furbrain/Cyclops/raspbian/diffraction.png

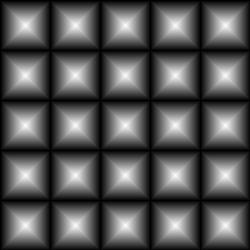
raspbian/diffraction.png
