furbrain/Cyclops/README.md

# Cyclops

Cave surveying with a camera and IMU. Under development
