furbrain/Cyclops/pcb/main/README.TXT

These files have been created in version 8 of KiCAD.

Some of the 3d models need to be downloaded form the following places and put into the CM5IO.3shapes directory some models are approximations.

https://datasheets.raspberrypi.org/cm5/CM5-step.zip
https://www.molex.com/molex/products/part-detail/memory_card_socket/5033981892

The models provided in the 3dmodels directory are from various manufacturers including Diodes, Hirose, MTCONN, Toby, TRXCOM. Terms and conditions for the use of the models remain with the original manufacture.
