furbrain/Cyclops/enclosures/main.FCStd

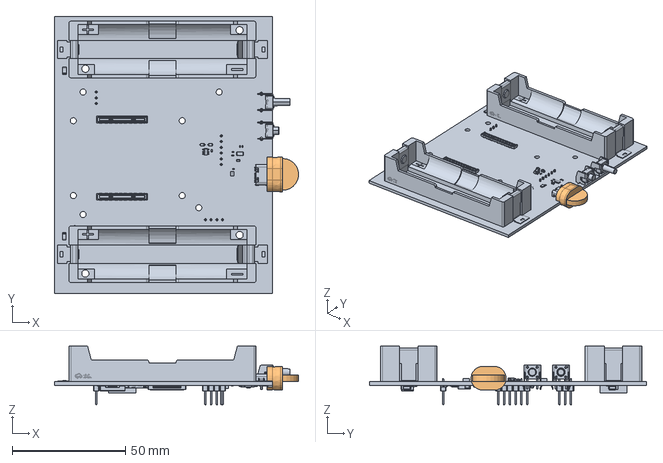
[picture p2: CAD file, 2026-10-15]
enclosures/main.FCStd
107.5 x 122.3 x 25.8 mm
CM5IO
Plug
