furbrain/Cyclops/enclosures/indicator.FCStd

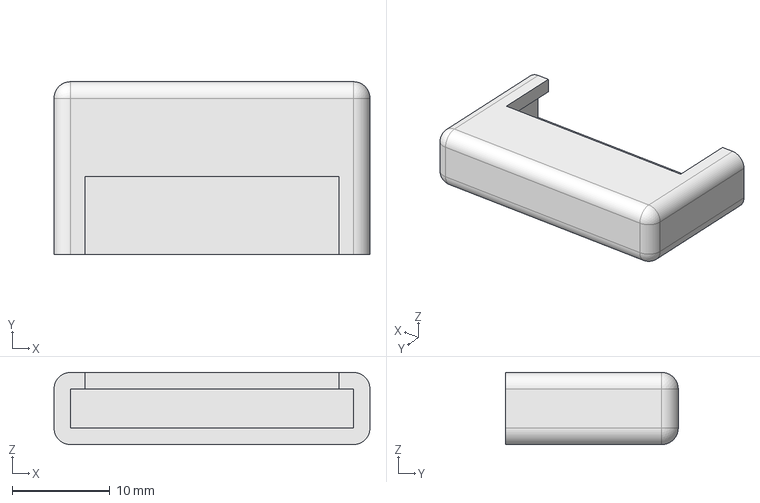
[picture p3: CAD file, 2026-09-15]
enclosures/indicator.FCStd
32.4 x 17.7 x 7.40 mm
