furbrain/Cyclops/enclosures/light_clip.FCStd

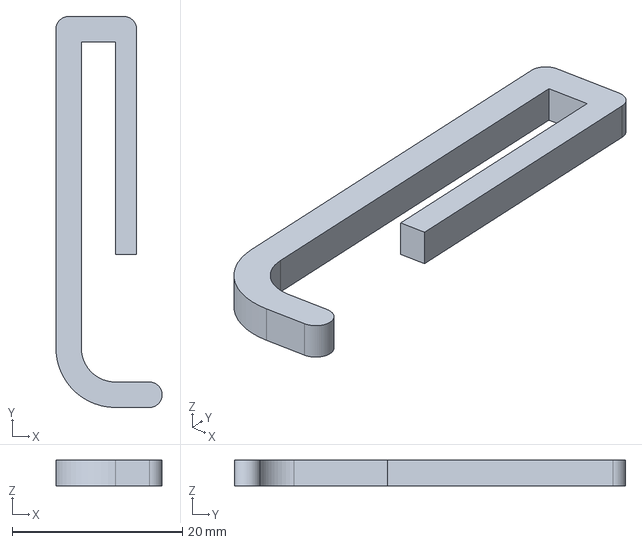
[picture p4: CAD file, 2026-09-15]
enclosures/light_clip.FCStd
12.5 x 46.0 x 3.00 mm
