furbrain/Cyclops/enclosures/vent.FCStd

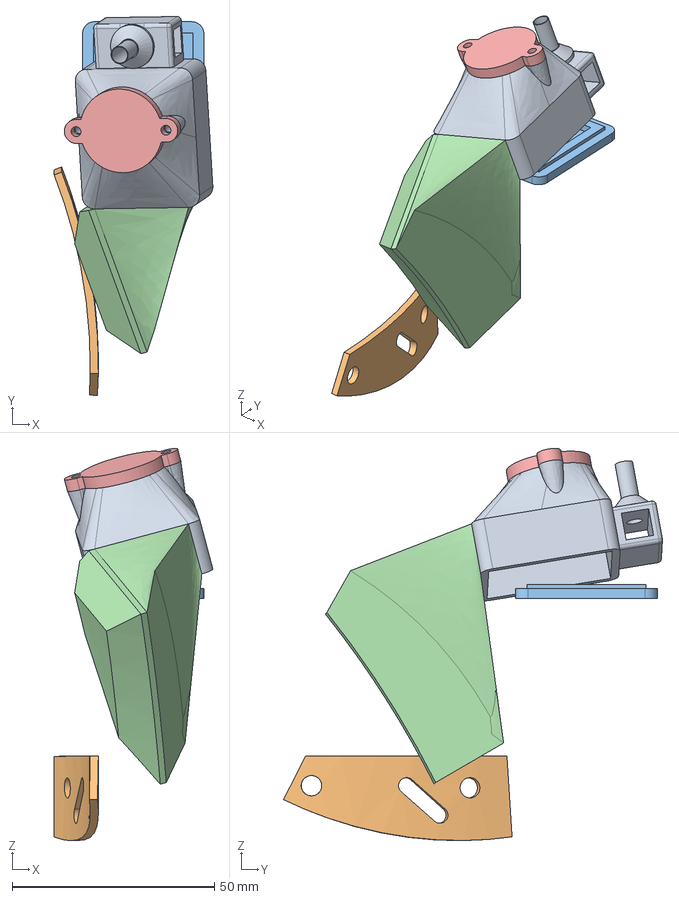
[picture p5: CAD file, 2026-06-04]
enclosures/vent.FCStd
39.2 x 93.6 x 96.9 mm
eye
Plate
backplate
neck
lens
