furbrain/Cyclops/enclosures/froggie_old.FCStd

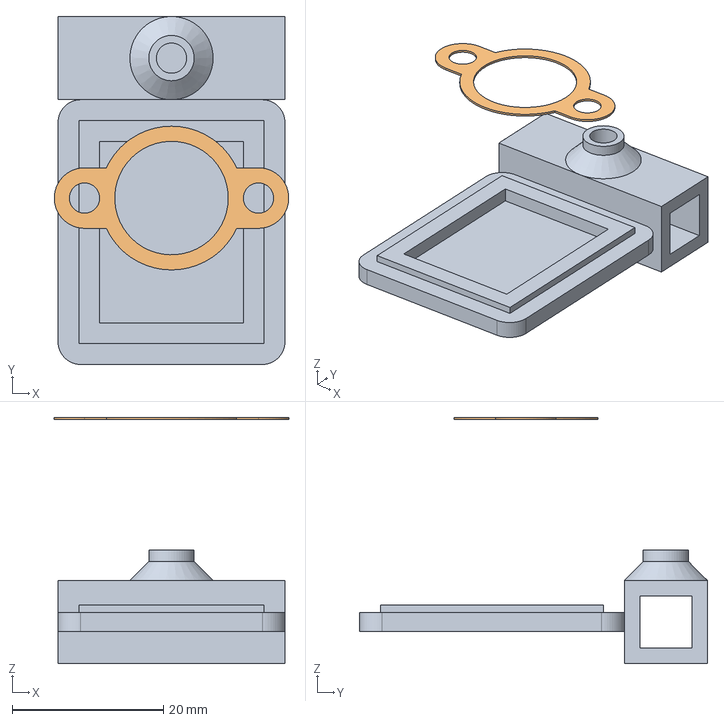
[picture p6: CAD file, 2026-06-04, an earlier design]
enclosures/froggie_old.FCStd
31.0 x 46.0 x 32.5 mm
backplate
Gasket
