furbrain/Cyclops/kalibr/calibration_pattern.pdf

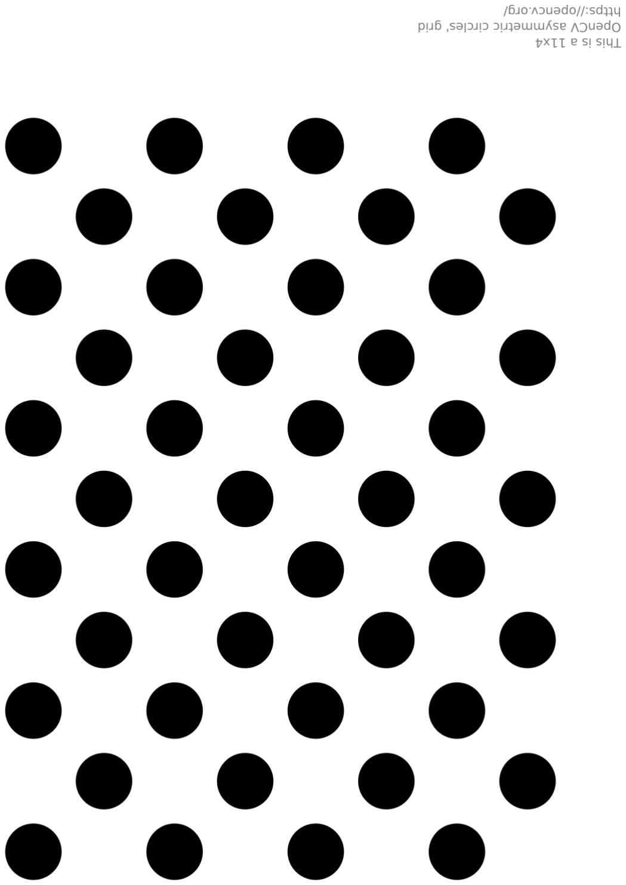
[picture p7: page 1]
