furbrain/Cyclops/pcb/indicator/indicator.kicad_pcb

## KiCad design pcb/indicator/indicator.kicad_pcb (2026-06-24)

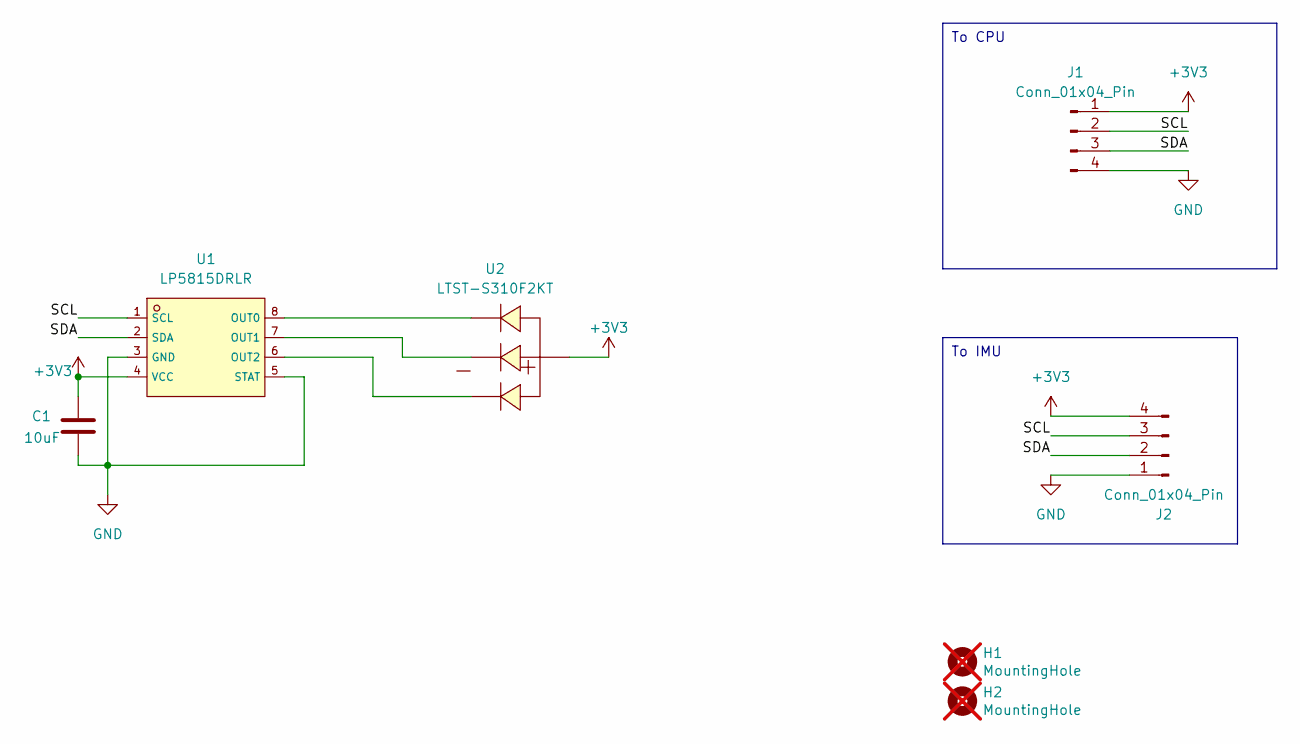
[picture p8: schematic indicator.kicad_sch]

Parts:
C1: 10uF; C_0805_2012Metric; JLCPCB C117956
H1, H2: MountingHole; MountingHole_3.2mm_M3; Part Description M2.5 mounting hole; not fitted
J1, J2: Conn_01x04_Pin; JUSHUO_AFA07-S04FCA-00_1x4-1MP_P1.0mm_Horizontal; JLCPCB C262710
U1: LP5815DRLR; SOT-583-8_L2.1-W1.2-P0.50-LS1.6-BL; JLCPCB C47262831
U2: LTST-S310F2KT; LED-SMD_4P-L3.2-W1.5_LTST-S310F2KT; JLCPCB C284950

Connections:
+3V3: C1.1, J1.1, J2.4, U1.4 (VCC), U2.4 (A)
/SCL: J1.2, J2.3, U1.1 (SCL)
/SDA: J1.3, J2.2, U1.2 (SDA)
GND: C1.2, J1.4, J2.1, U1.3 (GND), U1.5 (STAT)
unnamed: U1.8 (OUT0), U2.1 (C1)
unnamed: U1.7 (OUT1), U2.2 (C2)
unnamed: U1.6 (OUT2), U2.3 (C3)

Notes on the sheet:
To CPU
To IMU

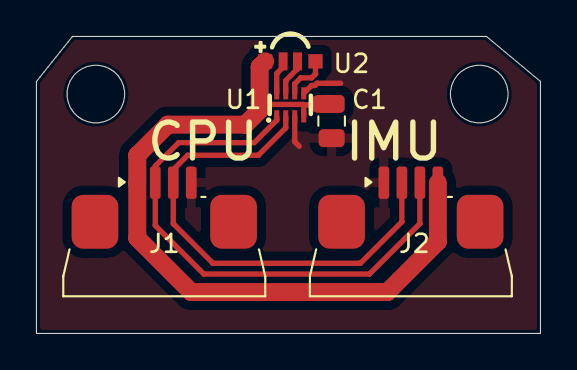
[picture p9: board indicator.kicad_pcb from above]

Board: 2 copper layers, 28.0 x 16.5 mm, 7 parts (0 on the bottom side), 7 nets.
