furbrain/Cyclops/pcb/charger_mod/charger_mod.kicad_pcb

## KiCad design pcb/charger_mod/charger_mod.kicad_pcb (2026-06-04)

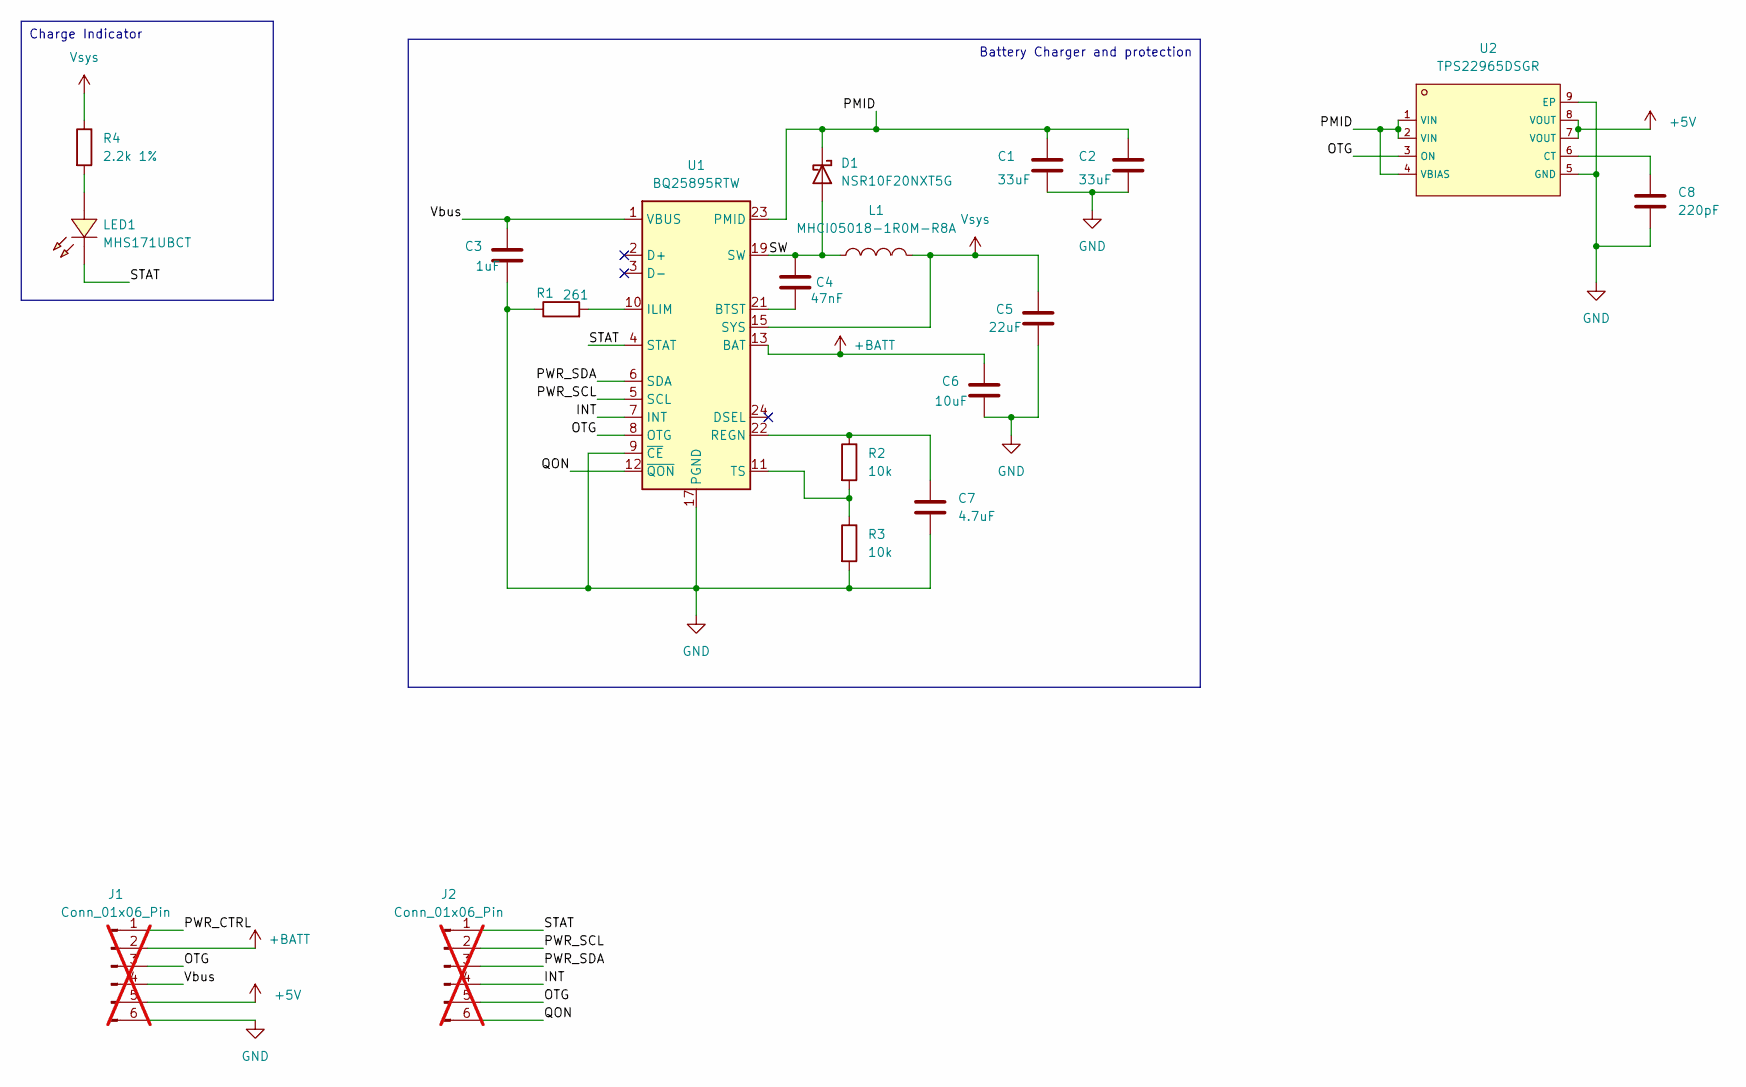
[picture p10: schematic charger_mod.kicad_sch]

Parts:
C1, C2: 33uF; C_1206_3216Metric; LCSC PN C76658
C3: 1uF; C_0603_1608Metric; LCSC PN C1592
C4: 47nF; C_0402_1005Metric; LCSC PN C106260
C5: 22uF; C_0805_2012Metric; LCSC PN C45783
C6: 10uF; C_0805_2012Metric; LCSC PN C117956
C7: 4.7uF; C_0603_1608Metric; LCSC PN C19666
C8: 220pF; C_0402_1005Metric; JLCPCB C1530
D1: NSR10F20NXT5G; Nexperia_DSN1608-2_1.6x0.8mm; LCSC PN C893809
J1, J2: Conn_01x06_Pin; PinHeader_1x06_P2.54mm_Vertical; not fitted
L1: MHCI05018-1R0M-R8A; IND-SMD_L5.7-W5.4; LCSC PN C329539
LED1: MHS171UBCT; LED-SMD_L2.1-W1.0-R-RD; LCSC PN C693906
R1: 261; R_0402_1005Metric; LCSC PN C25097
R2, R3: 10k; R_0402_1005Metric; LCSC PN C25744
R4: 2.2k 1%; R_0402_1005Metric; LCSC PN C25879
U1: BQ25895RTW; Texas_RTW_WQFN-24-1EP_4x4mm_P0.5mm_EP2.7x2.7mm_ThermalVias; LCSC PN C80200
U2: TPS22965DSGR; UDFN-8_L2.0-W2.0-P0.50-TL-EP; LCSC C122837

Connections:
+5V: J1.5, U2.7 (VOUT), U2.8 (VOUT)
+BATT: C6.1, J1.2, U1.13 (BAT), U1.14 (BAT)
/INT: J2.4, U1.7 (INT)
/OTG: J1.3, J2.5, U1.8 (OTG), U2.3 (ON)
/PMID: C1.1, C2.1, D1.1 (K), U1.23 (PMID), U2.1 (VIN), U2.2 (VIN), U2.4 (VBIAS)
/PWR_CTRL: J1.1
/PWR_SCL: J2.2, U1.5 (SCL)
/PWR_SDA: J2.3, U1.6 (SDA)
/QON: J2.6, U1.12 (~QON)
/STAT: J2.1, LED1.2 (K), U1.4 (STAT)
/SW: C4.1, D1.2 (A), L1.1, U1.19 (SW), U1.20 (SW)
/Vbus: C3.1, J1.4, U1.1 (VBUS)
GND: C1.2, C2.2, C3.2, C5.2, C6.2, C7.2, C8.2, J1.6, R1.1, R3.2, U1.9 (~CE), U1.17 (PGND), U1.18 (PGND), U1.25 (PGND), U2.5 (GND), U2.9 (EP)
unnamed: LED1.1 (A), R4.2
unnamed: C4.2, U1.21 (BTST)
unnamed: R1.2, U1.10 (ILIM)
unnamed: C7.1, R2.1, U1.22 (REGN)
unnamed: R2.2, R3.1, U1.11 (TS)
unnamed: C8.1, U2.6 (CT)
Vsys: C5.1, L1.2, R4.1, U1.15 (SYS), U1.16 (SYS)

Notes on the sheet:
Battery Charger and protection
Charge Indicator

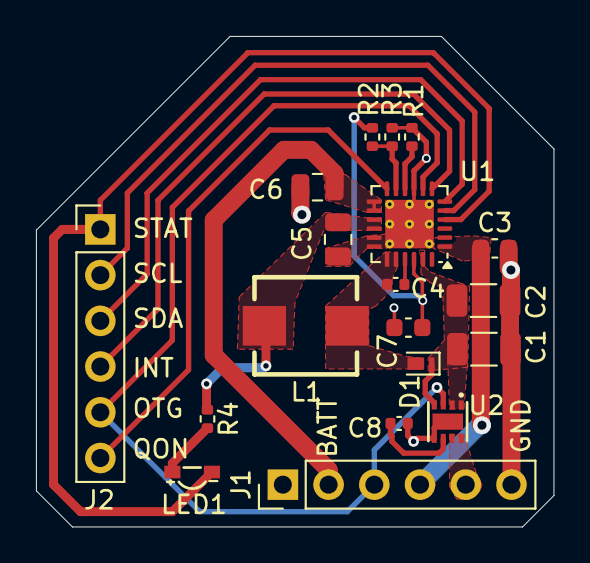
[picture p11: board charger_mod.kicad_pcb from above]

Board: 2 copper layers, 28.8 x 27.2 mm, 19 parts (0 on the bottom side), 19 nets.
