furbrain/Cyclops/pcb/imu/imu.kicad_pcb

## KiCad design pcb/imu/imu.kicad_pcb (2026-06-04)

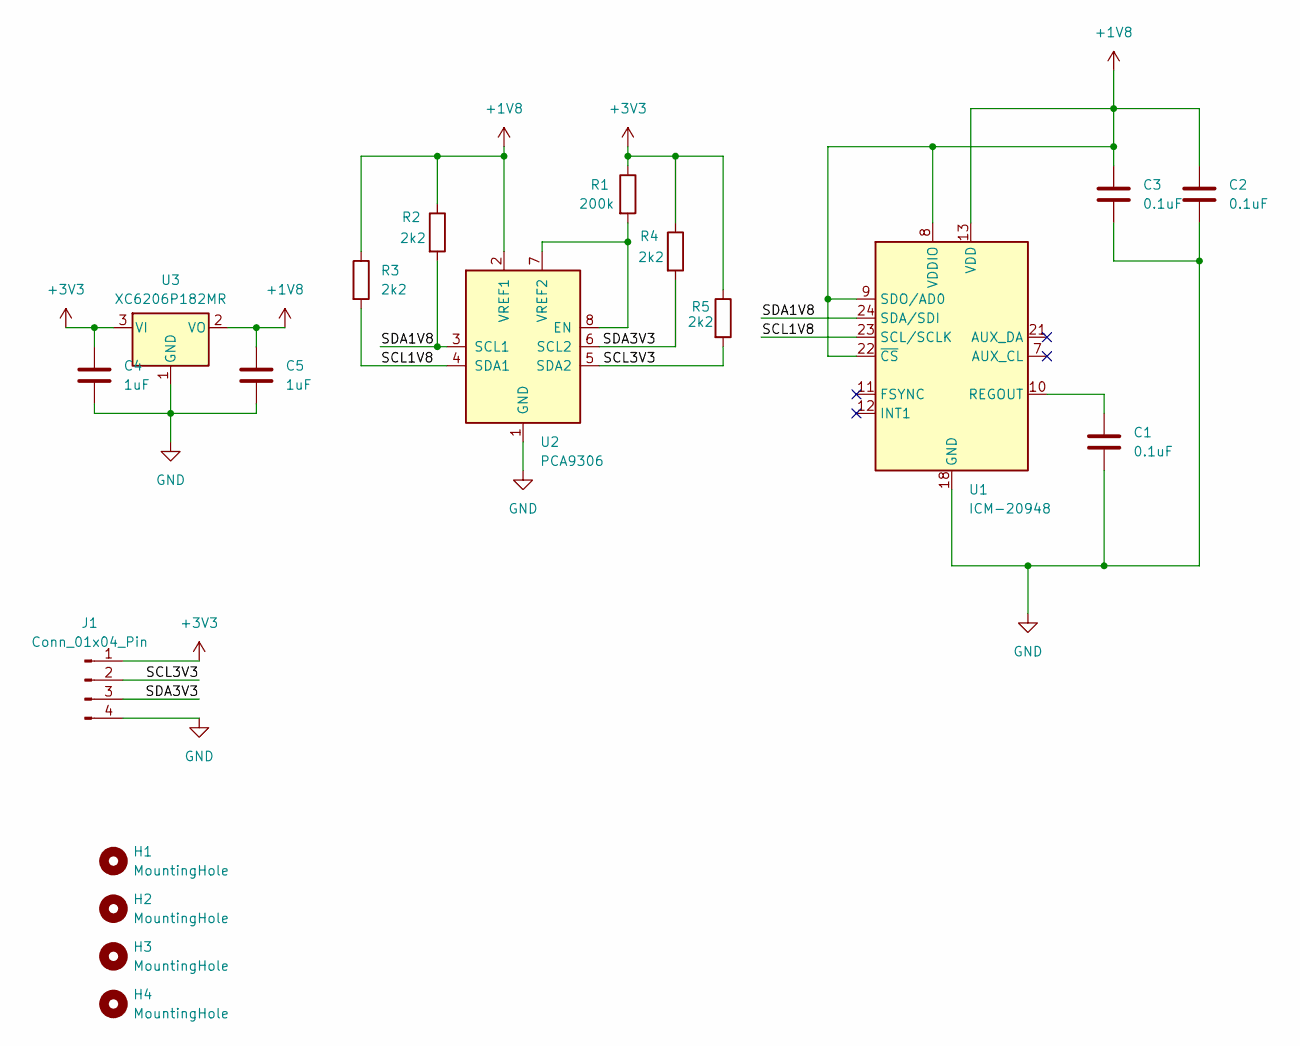
[picture p12: schematic imu.kicad_sch]

Parts:
C1, C2, C3: 0.1uF; C_0402_1005Metric
C4, C5: 1uF; C_0402_1005Metric
H1, H2, H3, H4: MountingHole; MountingHole_2.2mm_M2
J1: Conn_01x04_Pin; JUSHUO_AFA07-S04FCA-00_1x4-1MP_P1.0mm_Horizontal; JLCPCB C262710
R1: 200k; R_0402_1005Metric
R2, R3, R4, R5: 2k2; R_0402_1005Metric
U1: ICM-20948; InvenSense_QFN-24_3x3mm_P0.4mm
U2: PCA9306; VSSOP-8_2.3x2mm_P0.5mm
U3: XC6206P182MR; SOT-23-3; JLCPCB No C21659

Connections:
+1V8: C2.1, C3.1, C5.1, R2.1, R3.1, U1.8 (VDDIO), U1.9 (SDO/AD0), U1.13 (VDD), U1.22 (~CS), U2.2 (VREF1), U3.2 (VO)
+3V3: C4.1, J1.1, R1.1, R4.1, R5.1, U3.3 (VI)
/SCL1V8: R3.2, U1.23 (SCL/SCLK), U2.4 (SDA1)
/SCL3V3: J1.2, R5.2, U2.5 (SDA2)
/SDA1V8: R2.2, U1.24 (SDA/SDI), U2.3 (SCL1)
/SDA3V3: J1.3, R4.2, U2.6 (SCL2)
GND: C1.2, C2.2, C3.2, C4.2, C5.2, J1.4, U1.18 (GND), U1.20 (GND), U2.1 (GND), U3.1 (GND)
unnamed: C1.1, U1.10 (REGOUT)
unnamed: R1.2, U2.7 (VREF2), U2.8 (EN)

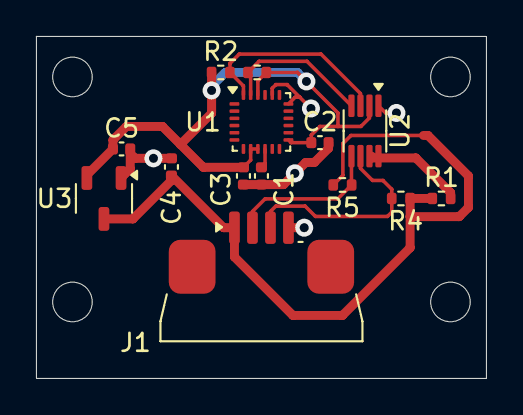
[picture p13: board imu.kicad_pcb from above]

Board: 2 copper layers, 25.0 x 19.0 mm, 18 parts (0 on the bottom side), 9 nets.
