furbrain/Cyclops/pcb/main/main.kicad_pcb

## KiCad design pcb/main/main.kicad_pcb (2026-06-04)

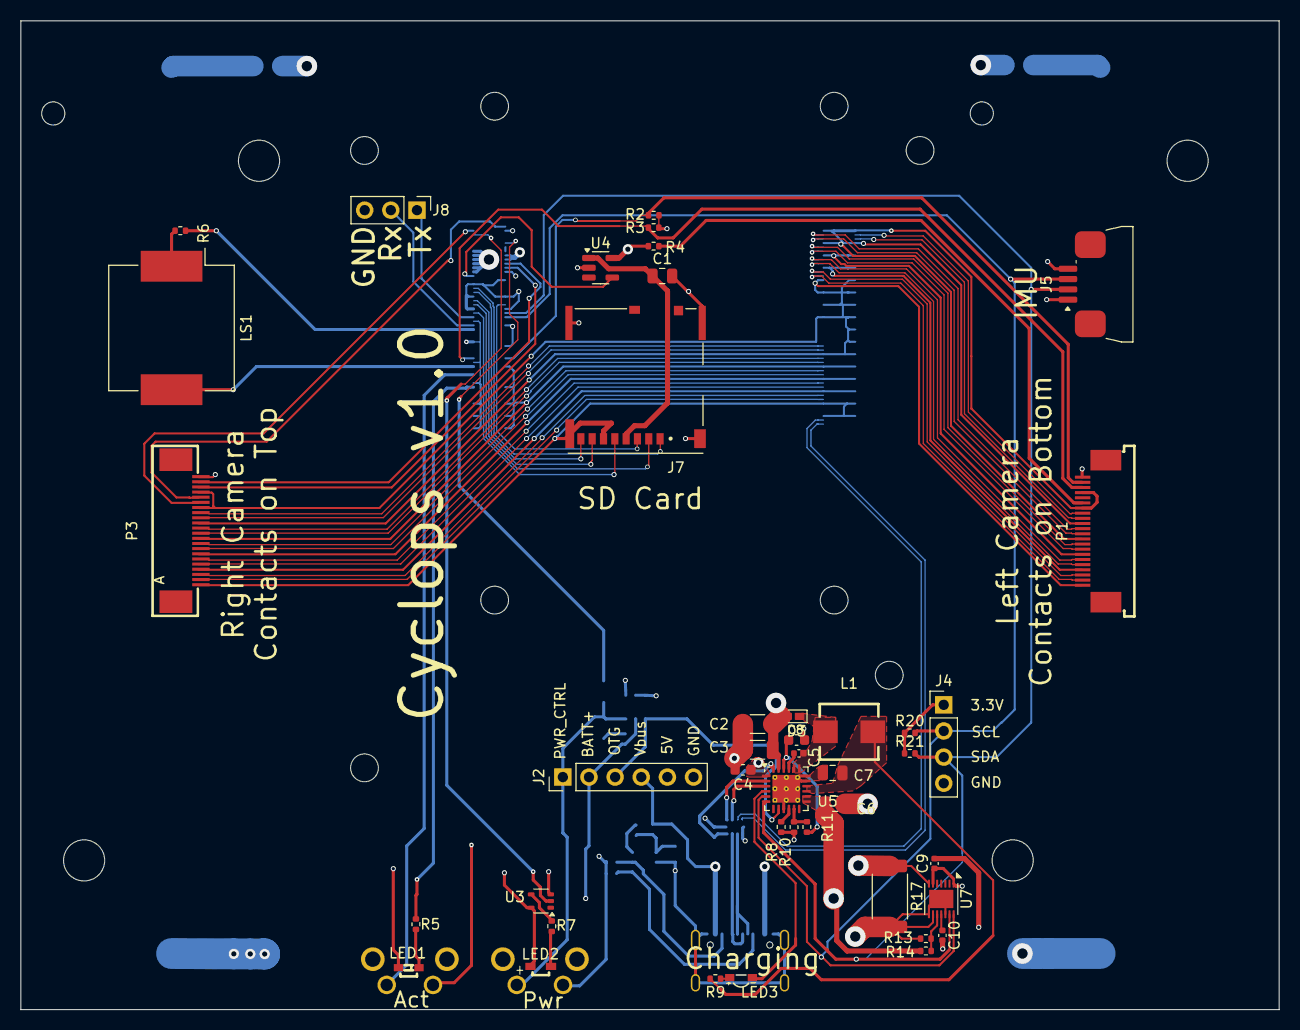
[picture p14: board main.kicad_pcb from above]

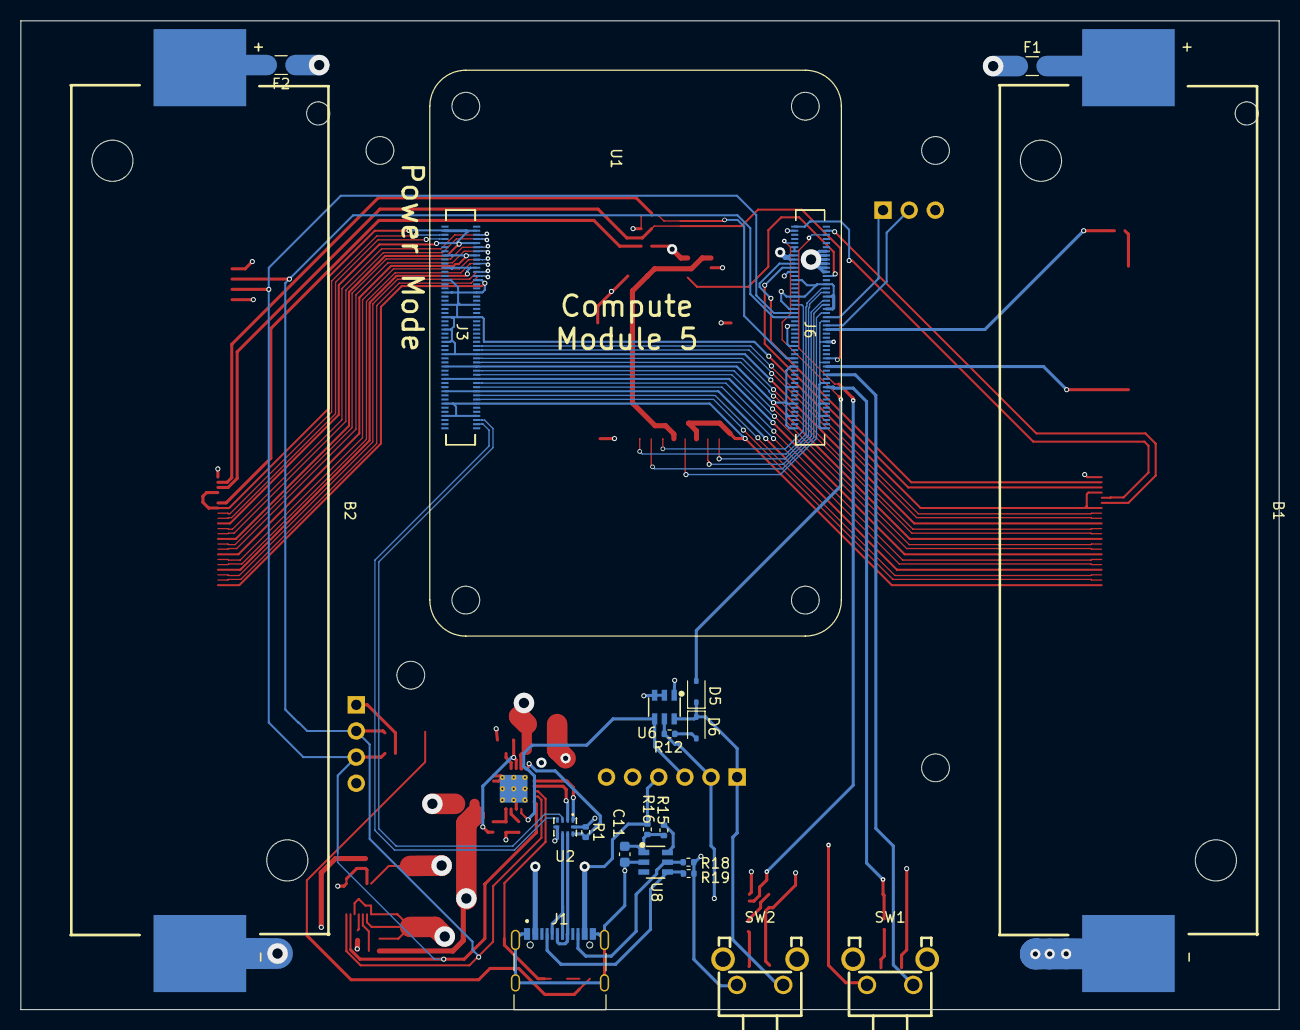
[picture p15: board main.kicad_pcb from below]

Board: 4 copper layers, 122.3 x 96.1 mm, 68 parts (22 on the bottom side), 82 nets.

Parts:
B1, B2: BH-21700-B1BJ001; BAT-SMD_L82.5.5-W25-BH-21700-B1BJ001
C1, C7: 10uF; C_0805_2012Metric
C2, C3: 33uF; C_1206_3216Metric
C4, C11: 1uF; C_0603_1608Metric
C5: 47nF; C_0402_1005Metric
C6: 22uF; C_0805_2012Metric
C8: 4.7uF; C_0603_1608Metric
C9: 100nF; C_0402_1005Metric
C10: 470nF; C_0402_1005Metric
D3: NSR10F20NXT5G; Nexperia_DSN1608-2_1.6x0.8mm
D5, D6: D_Schottky; D_SOD-323
F1, F2: Fuse; Fuse_1206_3216Metric
H1, H2, H3, H4: MountingHole; MountingHole_2.7mm_M2.5_DIN965
J1: TYPE-C-31-M-12; HRO_TYPE-C-31-M-12
J2: Conn_01x06_Pin; PinHeader_1x06_P2.54mm_Vertical
J3, J6: 10164227-1001A1RLF; CM5_connector
J4: Conn_01x04_Pin; PinHeader_1x04_P2.54mm_Vertical
J5: Conn_01x04_Pin; JUSHUO_AFA07-S04FCA-00_1x4-1MP_P1.0mm_Horizontal
J7: Micro_SD_Card_Det; SDCARD_MOLEX_503398-1892
J8: UART Connection; PinHeader_1x03_P2.54mm_Vertical
L1: MHCI05018-1R0M-R8A; IND-SMD_L5.7-W5.4
LED1: MHS171CYCT; LED-SMD_L2.0-W1.1-R-RD-SIDE_YELLOW
LED2: MHS171UGCT; LED-SMD_L2.0-W1.1_RD_GREEN_SIDE
LED3: MHS171UBCT; LED-SMD_L2.1-W1.0-R-RD
LS1: KMTG1203; Buzzer_Mallory_AST1240MLQ
P1: AFC07-S22FCC-00 (Bottom contact); FPC-SMD_AFC07-S22FCC-00
P3: FPC_0_5MM_22P_Pull_type_H2_0mm_Pick_up; FPC-SMD_P0.50-22P_LSSJ-H2.0-22P
R1, R10, R11, R12, R15: 10k; R_0402_1005Metric
R2, R3, R4, R20, R21: 2.2K 1%; R_0402_1005Metric
R5, R7, R16: 1k; R_0402_1005Metric
R6: 180; R_0402_1005Metric
R8: 261; R_0402_1005Metric
R9: 2.2k 1%; R_0402_1005Metric
R13: 300k; R_0402_1005Metric
R14: 200k; R_0402_1005Metric
R17: 10mOhm; R_2512_6332Metric
R18, R19: 5.1k; R_0402_1005Metric
SW1: TS-1093C-A14B3-D1; SW-TH_TS-1093C-A14B3-D1
SW2: TS-1093C-A5B3-D1; SW-TH_TS-1093C-A5B3-D1
U1: Raspberry-Pi-5-Compute-Module
U2: TS3USB221ARSER; UQFN-10_L2.0-W1.5-P0.50-BL
U3: 74LVC1G07SE-7; SOT-353_SC-70-5
U4: RT9742GGJ5; SOT-23-5
U5: BQ25895RTW; Texas_RTW_WQFN-24-1EP_4x4mm_P0.5mm_EP2.7x2.7mm_ThermalVias
U6: SN74LVC1G57DBVR; SOT-23-6_L2.9-W1.6-P0.95-LS2.8-BL
U7: MAX17261xxTD; TDFN-14-1EP_3x3mm_P0.4mm_EP1.78x2.35mm
U8: CH221K; SOT-23-6_L2.9-W1.6-P0.95-LS2.8-BL-2

Connections:
+BATT: C7.1, C9.1, F1.1, F2.1, J2.2, R12.1, R13.1, U5.13 (BAT), U5.14 (BAT), U6.5 (VCC), U7.1 (TH), U7.6 (BATT)
-BATT: B1.2, B2.2, C9.2, C10.2, R14.2, R17.2, U7.8 (GND), U7.9 (CSPL), U7.12 (ALRT), U7.15 (GND)
/+3.3v: J4.1, J5.4, J6.78 (GPIO_VREF(1.8v/3.3v_Input)), J6.84 (+3.3v_(Output)), J6.86 (+3.3v_(Output)), LED1.1 (K), LED2.1 (+), P1.1, P3.1, R1.1, R2.1, R3.1, R4.1, R20.1, R21.1, U2.10 (VCC), U3.5 (VCC), U4.5 (IN), U6.1 (IN1)
/CC1: J1.A5 (CC1), R19.1, U8.4 (CC1)
/CC2: J1.B5 (CC2), R18.2, U8.5 (CC2)
/CM5_5V: C2.1, C3.1, D3.1 (K), J2.5, J6.77 (+5v_(Input)), J6.79 (+5v_(Input)), J6.81 (+5v_(Input)), J6.83 (+5v_(Input)), J6.85 (+5v_(Input)), J6.87 (+5v_(Input)), U5.23 (PMID)
/CM5_GPIO ( Ethernet, GPIO, SDCARD)/+1.8v: J6.88 (+1.8v_(Output)), J6.90 (+1.8v_(Output))
/CM5_GPIO ( Ethernet, GPIO, SDCARD)/BUTTON: J6.27 (GPIO20), SW1.2
/CM5_GPIO ( Ethernet, GPIO, SDCARD)/BUZZ_A: J6.49 (GPIO18), R6.1
/CM5_GPIO ( Ethernet, GPIO, SDCARD)/BUZZ_B: J6.31 (GPIO12), LS1.2
/CM5_GPIO ( Ethernet, GPIO, SDCARD)/CAM_GPIO0: J6.97 (CAM_GPIO0), P3.6
/CM5_GPIO ( Ethernet, GPIO, SDCARD)/CAM_GPIO1: J6.100 (CAM_GPIO1), P3.5
/CM5_GPIO ( Ethernet, GPIO, SDCARD)/GPIO14: J6.55 (GPIO14), J8.1
/CM5_GPIO ( Ethernet, GPIO, SDCARD)/GPIO15: J6.51 (GPIO15), J8.2
/CM5_GPIO ( Ethernet, GPIO, SDCARD)/ID_SC: J6.35 (ID_SC), P1.3, R3.2
/CM5_GPIO ( Ethernet, GPIO, SDCARD)/ID_SD: J6.36 (ID_SD), P1.2, R2.2
/CM5_GPIO ( Ethernet, GPIO, SDCARD)/SD_CLK: J6.57 (SD_CLK), J7.5 (CLK)
/CM5_GPIO ( Ethernet, GPIO, SDCARD)/SD_CMD: J6.62 (SD_CMD), J7.3 (CMD)
/CM5_GPIO ( Ethernet, GPIO, SDCARD)/SD_DAT0: J6.63 (SD_DAT0), J7.7 (DAT0)
/CM5_GPIO ( Ethernet, GPIO, SDCARD)/SD_DAT1: J6.67 (SD_DAT1), J7.8 (DAT1)
/CM5_GPIO ( Ethernet, GPIO, SDCARD)/SD_DAT2: J6.69 (SD_DAT2), J7.1 (DAT2)
/CM5_GPIO ( Ethernet, GPIO, SDCARD)/SD_DAT3: J6.61 (SD_DAT3), J7.2 (DAT3/CD)
/CM5_GPIO ( Ethernet, GPIO, SDCARD)/SD_PWR: C1.1, J7.4 (VDD), U4.1 (OUT)
/CM5_GPIO ( Ethernet, GPIO, SDCARD)/SD_PWR_ON: J6.75 (SD_PWR_ON), U4.4 (EN)
/CM5_GPIO ( Ethernet, GPIO, SDCARD)/nPWR_LED: J6.95 (LED_nPWR), U3.2
/CM5_HighSpeed/DPHY0_C_N: J3.27 (MIPI0_C_N), P3.15
/CM5_HighSpeed/DPHY0_C_P: J3.29 (MIPI0_C_P), P3.14
/CM5_HighSpeed/DPHY0_D0_N: J3.15 (MIPI0_D0_N), P3.21
/CM5_HighSpeed/DPHY0_D0_P: J3.17 (MIPI0_D0_P), P3.20
/CM5_HighSpeed/DPHY0_D1_N: J3.21 (MIPI0_D1_N), P3.18
/CM5_HighSpeed/DPHY0_D1_P: J3.23 (MIPI0_D1_P), P3.17
/CM5_HighSpeed/DPHY0_D2_N: J3.33 (MIPI0_D2_N), P3.12
/CM5_HighSpeed/DPHY0_D2_P: J3.35 (MIPI0_D2_P), P3.11
/CM5_HighSpeed/DPHY0_D3_N: J3.39 (MIPI0_D3_N), P3.9
/CM5_HighSpeed/DPHY0_D3_P: J3.41 (MIPI0_D3_P), P3.8
/CM5_HighSpeed/DPHY1_C_N: J3.87 (MIPI1_C_N), P1.15
/CM5_HighSpeed/DPHY1_C_P: J3.89 (MIPI1_C_P), P1.14
/CM5_HighSpeed/DPHY1_D0_N: J3.75 (MIPI1_D0_N), P1.21
/CM5_HighSpeed/DPHY1_D0_P: J3.77 (MIPI1_D0_P), P1.20
/CM5_HighSpeed/DPHY1_D1_N: J3.81 (MIPI1_D1_N), P1.18
/CM5_HighSpeed/DPHY1_D1_P: J3.83 (MIPI1_D1_P), P1.17
/CM5_HighSpeed/DPHY1_D2_N: J3.93 (MIPI1_D2_N), P1.12
/CM5_HighSpeed/DPHY1_D2_P: J3.95 (MIPI1_D2_P), P1.11
/CM5_HighSpeed/DPHY1_D3_N: J3.94 (MIPI1_D3_N), P1.9
/CM5_HighSpeed/DPHY1_D3_P: J3.96 (MIPI1_D3_P), P1.8
/CM5_HighSpeed/SCL0: J6.80 (SCL0), P3.3
/CM5_HighSpeed/SDA0: J6.82 (SDA0), P3.2
/CM5_USB2_N: J3.3 (USB2_N), U2.4 (2D-)
/CM5_USB2_P: J3.5 (USB2_P), U2.3 (2D+)
/DSEL: R1.2, U2.9 (S), U5.24 (DSEL)
/PWR_BUT: D5.2 (A), J6.92 (PWR_BUT)
/PWR_D+: U2.1 (1D+), U5.2 (D+)
/PWR_D-: U2.2 (1D-), U5.3 (D-)
/PWR_SCL: J4.2, J5.3, J6.56 (GPIO3), R20.2, U5.5 (SCL), U7.14 (SCL)
/PWR_SDA: J4.3, J5.2, J6.58 (GPIO2), R21.2, U5.6 (SDA), U7.13 (SDA)
/Power/OTG: J2.3, U5.8 (OTG), U6.4 (Y)
/Power/PWR_CTRL: D5.1 (K), D6.1 (K), J2.1, SW2.2, U6.6 (IN2)
/Power/STAT: LED3.2 (K), U5.4 (STAT)
/Power/SW: C5.1, D3.2 (A), L1.1, U5.19 (SW), U5.20 (SW)
/USB2_N: J1.A7 (DN1), J1.B7 (DN2), U2.7 (D-)
/USB2_P: J1.A6 (DP1), J1.B6 (DP2), U2.8 (D+)
/Vbus: C4.1, J1.A4_B9 (VBUS), J1.B4_A9 (VBUS), J2.4, R16.1, U5.1 (VBUS)
GND: C1.2, C2.2, C3.2, C4.2, C6.2, C7.2, C8.2, C11.2, J1.A1_B12 (GND), J1.B1_A12 (GND), J1.S1 (SHIELD), J1.S2 (SHIELD), J1.S3 (SHIELD), J1.S4 (SHIELD), J2.6, J3.7 (GND), J3.8 (GND), J3.13 (GND), J3.14 (GND), J3.19 (GND), J3.20 (GND), J3.25 (GND), J3.26 (GND), J3.31 (GND), J3.32 (GND), J3.37 (GND), J3.38 (GND), J3.44 (GND), J3.50 (GND), J3.55 (GND), J3.56 (GND), J3.61 (GND), J3.62 (GND), J3.67 (GND), J3.68 (GND), J3.73 (GND), J3.74 (GND), J3.79 (GND), J3.80 (GND), J3.85 (GND), J3.86 (GND), J3.91 (GND), J3.92 (GND), J3.97 (GND), J3.98 (GND), J4.4, J5.1, J6.1 (GND), J6.2 (GND), J6.7 (GND), J6.8 (GND), J6.13 (GND), J6.14 (GND), J6.22 (GND), J6.23 (GND), J6.32 (GND), J6.33 (GND), J6.42 (GND), J6.43 (GND), J6.52 (GND), J6.53 (GND), J6.59 (GND), J6.60 (GND), J6.65 (GND), J6.66 (GND), J6.71 (GND), J6.74 (GND), J6.98 (GND), J7.6 (VSS), J7.11 (SHIELD), J8.3, P1.4, P1.7, P1.10, P1.13, P1.16, P1.19, P1.22, P3.4, P3.7, P3.10, P3.13, P3.16, P3.19, P3.22, R8.1, R11.2, R17.1, R18.1, R19.2, SW1.1, SW2.1, U2.5 (GND), U2.6 (OE#), U3.3 (GND), U4.2 (GND), U5.9 (~CE), U5.17 (PGND), U5.18 (PGND), U5.25 (PGND), U6.2 (GND), U6.3 (IN0), U7.7 (CSN), U8.2 (GND)
unnamed: B1.1, F1.2
unnamed: B2.1, F2.2
unnamed: D6.2 (A), R12.2
unnamed: J6.21 (LED_nACT), R5.2
unnamed: LED1.2 (A), R5.1
unnamed: LED2.2 (-), R7.1
unnamed: LED3.1 (A), R9.2
unnamed: LS1.1, R6.2
unnamed: P1.6, R4.2
unnamed: R7.2, U3.4
unnamed: C5.2, U5.21 (BTST)
unnamed: R8.2, U5.10 (ILIM)
unnamed: C8.1, R10.1, U5.22 (REGN)
unnamed: R10.2, R11.1, U5.11 (TS)
unnamed: R13.2, R14.1, U7.10 (CELLX)
unnamed: C10.1, U7.11 (REG)
unnamed: R15.2, U8.6 (CFG)
unnamed: C11.1, R15.1, R16.2, U8.1 (VDD)
Vsys: C6.1, L1.2, R9.1, U5.15 (SYS), U5.16 (SYS)
