furbrain/Cyclops/raspbian/atlas_viewer.py

#!/usr/bin/env python3
import json
from itertools import chain
from typing import List, Dict

import argparse
import gtsam
import numpy as np
import scipy.spatial.transform as sst

import rclpy
import rclpy.node
from std_msgs.msg import Header, ColorRGBA
from sensor_msgs.msg import PointCloud2
from geometry_msgs.msg import PoseArray, Pose, Point
from sensor_msgs_py import point_cloud2
from visualization_msgs.msg import MarkerArray, Marker

import orb_slam3_py
from orb_slam3_py import Leg
from merge_maps import InternalConnections
from atlas_tools import Atlas
from survey import SVXParser


def _get_point32_from_value(values, key):
    pos = Point()
    pos.x, pos.y, pos.z = values.atPoint3(key)
    return pos


class CaveViewer(rclpy.node.Node):
    def __init__(self, fname: str, all_maps = False, connections=None, align=True):
        super().__init__('cave_viewer')
        self.point_pub = self.create_publisher(PointCloud2, '/points', 10)
        self.pose_pub = self.create_publisher(PoseArray, '/pose', 10)
        self.marker_pub = self.create_publisher(MarkerArray, '/marker', 10)
        self.timer = self.create_timer(1, self.callback)
        self.markers = MarkerArray()
        atlas = Atlas.from_file(fname)
        if align:
            orb_slam3_py.align_atlas(atlas.atlas)
        if all_maps:
            kfs = atlas.atlas.get_all_keyframes()
            mps = atlas.atlas.get_all_map_points()
        else:
            m0: orb_slam3_py.Map
            m0 = list(sorted(atlas.atlas.get_all_maps(), key = lambda m: m.keyframes_in_map()))[-1]
            kfs = m0.get_all_keyframes()
            mps = m0.get_all_map_points()
        mps = {x.id: x for x in mps}
        hdr = Header()
        hdr.frame_id = "map"
        hdr.stamp = self.get_clock().now().to_msg()
        points: List[np.ndarray] = [m.get_world_pos() for m in mps.values()]
        poses: List[gtsam.Pose3] = [kf.get_pose().inv() for kf in kfs]
        points = np.array(points)
        print(f"Displaying {points.shape[0]} points")
        self.points = point_cloud2.create_cloud_xyz32(hdr, points.astype(np.float32))
        if connections:
            pos = np.array([mps[x].get_world_pos() for x in chain(*connections) if x in mps])
            print(f"Displaying {pos.shape[0]} connections")
            self.connections = point_cloud2.create_cloud_xyz32(hdr, pos.astype(np.float32))
            self.conn_pub = self.create_publisher(PointCloud2, '/connections', 10)
        else:
            self.connections = []
            self.conn_pub = None
        self.poses = PoseArray()
        self.poses.header = hdr
        pose: sst.RigidTransform
        for pose in poses:
            p = Pose()
            p.position.x, p.position.y, p.position.z = pose.translation
            q = pose.rotation.as_quat()
            p.orientation.x, p.orientation.y, p.orientation.z, p.orientation.w = q
            self.poses.poses.append(p)

    def callback(self):
        self.point_pub.publish(self.points)
        self.pose_pub.publish(self.poses)
        if self.conn_pub:
            self.conn_pub.publish(self.connections)
        # self.marker_pub.publish(self.markers)

parser = argparse.ArgumentParser(description="Create a colmap from a bag (ROS1 or ROS2)")
parser.add_argument('-a', '--atlas', help="provide an atlas message file to use", required=True)
parser.add_argument('-c', '--connections', help="list of connected points to highlight")
parser.add_argument('--maps', '-m', help="show all maps", action="store_true")
parser.add_argument('--align', help="align map with IMU", action="store_true")

opts = parser.parse_args()

rclpy.init()
if opts.connections is not None:
    with open(opts.connections) as f:
        conn = InternalConnections.from_json(f.read())
    connections = conn.get_connected_points()
else:
    connections = []
viewer = CaveViewer(opts.atlas, opts.maps, connections, align=opts.align)
rclpy.spin(viewer)
