furbrain/Cyclops/(commit log)

2024-03-09 Initial frame
    [frame.FCStd, frame.stl, slider.stl]
2024-03-09 Add first attempt at pHAT. Note GND connected wrong
    [cyclops-B_Cu.gbr, cyclops-B_Silkscreen.gbr, cyclops-Edge_Cuts.gbr, cyclops-F_Cu.gbr, cyclops-F_Silkscreen.gbr, cyclops-NPTH.drl, cyclops-PTH.drl, cyclops-User_Comments.gbr]
2024-03-10 Make imu_data time sensitive, add test script
2024-03-10 Get combined video+imu_data working
2024-05-19 recorder script with button and feedback
2024-08-24 Enclosure and clips
    [case.stl, clipa.stl, clipb.stl, frame.FCStd, lid.stl]
2024-08-24 Fix bug and remove calibration from here...
2024-09-15 Start thinking about TOF camera
2024-09-16 Increase resolution of camera feed
2024-09-16 Start using TOF camera
2024-09-21 condense TOF output and adjust for cameras changing ID
2024-09-28 switch to using depth mode
2024-10-26 Improve calibration processes, start work on dual calibration
2025-01-11 Lens calibration for dual cameras
2025-01-11 Switch to using posix-ipc and semaphores
2025-01-12 Playing with kalman filters
2025-01-12 make more modular camera finder
2025-02-23 make sensors rate aware
2025-08-25 switching to ROS2
2025-09-07 update cyclops
    [calibration.yaml]
2025-09-07 Add interface for calibration action
2025-09-07 add tof camera code
2025-09-09 Get lens calibration working: DONE
2025-09-12 Get web calibration working for camera and camera - camera
    [calibration.yaml]
2025-09-15 get 3d viewer working with point clouds and markers
    [calibration.yaml]
2025-09-24 get cameras sync'd
2025-10-14 Add mode switcher
    [calibration.yaml]
2025-11-16 Fixing calibration procedures
    [calibration.yaml]
2025-11-28 add button monitor to start and stop capture on button press
2026-01-02 New PCB
    [CM5IO.kicad_pcb, CM5IO.kicad_sch, CM5_GPIO.kicad_sch, CM5_HighSpeed.kicad_sch, PCIe-M2.kicad_sch]
2026-01-02 Various pcb mods
    [CM5IO.kicad_pcb, CM5IO.kicad_sch, CM5_GPIO.kicad_sch, CM5_HighSpeed.kicad_sch]
2026-03-20 various launch changes
    [calibration.yaml]
2026-03-20 add frog case
2026-04-18 battery holder
    [BatteryHolder.FCStd]
2026-05-24 add battery monitor node
2026-06-02 add clip-on case
    [case.FCStd]
2026-06-04 switch over to binocular views
    [calibration.yaml]
2026-06-04 various bits and bobs to make stereo work
    [calibration.yaml]
2026-06-04 case designs
    [froggie.FCStd]
2026-06-04 adding power management to board
    [CM5IO.kicad_sch, CM5_GPIO.kicad_sch, power.kicad_sch]
2026-06-04 Finalise v1.0 design
    [CM5IO.kicad_pcb, CM5IO.kicad_sch, CM5_GPIO.kicad_sch, CM5_HighSpeed.kicad_sch, power.kicad_sch]
2026-06-04 add correct pins for beep server
    [beep_server.py]
2026-06-04 switch to ICM20948 jobbie
2026-06-04 updated hardware files
    [CM5IO.kicad_pcb, CM5IO.kicad_sch, froggie.FCStd, power.kicad_sch]
2026-06-04 Create charger mod board
    [charger_mod.kicad_pcb, charger_mod.kicad_sch]
2026-06-04 imu board
    [imu.kicad_pcb, imu.kicad_sch]
2026-06-04 calibration patterns and other oddments
2026-06-04 create hardware for vertex
    [main.FCStd, vent.FCStd]
2026-06-04 add launch files to include battery, CPU and mem info
2026-06-04 Move main pcb from v3 to proper pcb dir, and rename from CM5IO to main
    [CM5IO.kicad_pcb, CM5IO.kicad_sch, CM5_GPIO.kicad_sch, CM5_HighSpeed.kicad_sch, GPIO.kicad_sch, HighSpeed.kicad_sch, PCIe-M2.kicad_sch, main.kicad_pcb]
2026-06-04 move charger module and imu pcbs to pcb dir
    [charger_mod.kicad_pcb, charger_mod.kicad_sch, imu.kicad_pcb, imu.kicad_sch]
2026-06-04 remove unused hardware dir
    [cyclops-B_Cu.gbr, cyclops-B_Silkscreen.gbr, cyclops-Edge_Cuts.gbr, cyclops-F_Cu.gbr, cyclops-F_Silkscreen.gbr, cyclops-NPTH.drl, cyclops-PTH.drl, cyclops-User_Comments.gbr]
2026-06-04 move enclosure files into dedicated directory
    [froggie_old.FCStd, main.FCStd, vent.FCStd]
2026-06-04 remove unused files
    [case.stl, clipa.stl, clipb.stl, frame.FCStd, frame.stl, lid.stl, slider.stl]
2026-06-04 remove unneeded files
    [BatteryHolder.FCStd, case.FCStd]
2026-06-11 FIx plug design
    [main.FCStd]
2026-06-11 add pin button and starts of bq25895 code
2026-06-12 More robust (and simpler) camera launch
2026-06-24 Add code to make diffraction lens
2026-06-24 Create indicator module
    [indicator.kicad_pcb, indicator.kicad_sch]
2026-08-02 Switch to using keyframe id for images
2026-08-04 add LP5815 driver
2026-08-30 Fix bug where T_c1c2 is provided inverted to orb_slam3
    [calibrate_dual.py, orb_make_settings.py, tf2_dynamic.py]
2026-08-30 add LED feedback
2026-08-30 code to correct an atlas which has been created with left-right inversion bug
    [correct_atlas.py]
2026-09-05 Switch to using atlas_tools
2026-09-15 add hardware bits - indicator jobbie and also clip to hold light in place
    [indicator.FCStd, light_clip.FCStd]
2026-10-13 switch images.tar as image repo
2026-10-25 switch to json atlas
2026-11-07 switch to json atlas files
2026-11-07 remove rosbag dependency and switch to images.tar storage
