furbrain/Cyclops/(notices)

Notices in the files:
pcb/main/PCIe-M2.kicad_sch:
Copyright © 2024 Raspberry Pi Ltd.
pcb/main/main.kicad_sch:
Copyright © 2026 Underwood Underground
